brianjk66/Controls-Research-Project/Ordered Parts/Bill of Materials.xlsx

Part | Quantity | Manufacturer | Manufacturer's Part # | Vendor | Vendor's Part # | Unit Price | Total Price | Description | Link
Ball Bearings | 2 | BC Precision | 50BC608ZZ | Amazon | 692128467461 | $0.38 | $0.76 | 608ZZ 8x22x7 Shielded Greased Miniature Ball Bearings | https://www.amazon.com/8x22x7-Shielded-Greased-Miniature-Bearings/dp/B00NX3F6F0
12V Power Supply | 1 | Lighting EVER | 5000028-US | Amazon | B00DKSI0S8 | $9.99 | $9.99 | LE Power Adapter, Transformers, Power Supply For LED Strip, Output 12V DC, 3A Max, 36 Watt Max, UL Listed | https://www.amazon.com/gp/product/B00DKSI0S8/ref=ox_sc_act_title_1?smid=AAF37WJS3P6BT&psc=1
M2 Screws | 2 | uxcell | A15120300UX0205 | Amazon | B01AXUS1MK | $0.07 | $0.14 | M2x14mm Thread Button Head Hex Socket Cap Screw Bolt | https://www.amazon.com/dp/B01AXUS1MK/_encoding=UTF8?coliid=I1D9HRL21A9ZG0&colid=1JXZ7HW0RYXH1&psc=0
M2 Nuts | 2 | uxcell | A16041800UX0465 | Amazon | B01MXF5HPM | $0.04 | $0.09 | M2 x 1.5mm Brass Internal Threaded Hexagon Hex Nuts | https://www.amazon.com/dp/B01MXF5HPM/_encoding=UTF8?coliid=I2JM7CYB0853WF&colid=1JXZ7HW0RYXH1&psc=0
M3 Screws | 4 | StarTech | SCREWM3 | Amazon | B00032Q1J4 | $0.10 | $0.41 | PC Mounting Computer Screws M3x1/4" Long Standoff, 50 Pack | https://www.amazon.com/dp/B00032Q1J4/_encoding=UTF8?coliid=I3N2TUG8GXM37M&colid=1JXZ7HW0RYXH1&psc=1
M3 Standoffs | 4 | uxcell | A12092200UX0087 | Amazon | 31161816 | $0.14 | $0.56 | 50 Pcs M3 Male x M3 Female Hex PCB Standoffs 12mm Length | https://www.amazon.com/uxcell%C2%AE-Female-Standoffs-Spacers-Length/dp/B00AH8DEVW
M3 Nuts | 4 | Amico | A13092700UX0955 | Amazon | 700724341402 | $0.05 | $0.18 | 100Pcs M3 3mm Female Thread Hex Metal Nut Fastener | https://www.amazon.com/100Pcs-Female-Thread-Fastener-Silver/dp/B00GYS1SXU?rps=1
M4 Screws | 1 | Small Parts | FSCM440JISSZ | Amazon | B00F32EDI0 | $0.16 | $0.16 | Steel Machine Screw, Zinc Plated, M4, 40 mm Length | https://www.amazon.com/gp/product/B00F32EDI0/ref=oh_aui_detailpage_o00_s00?ie=UTF8&psc=1
M4 Nuts | 1 | uxcell | A15052500UX0288 | Amazon | B0143GL55A | $0.07 | $0.07 | Metric M4 Hex Nut 304 Stainless Steel Fastener 100pcs | https://www.amazon.com/gp/product/B0143GL55A/ref=oh_aui_detailpage_o00_s00?ie=UTF8&psc=1
Microcontroller | 1 | Elegoo | EL-CB-005 | Amazon | B0713XK923 | $3.95 | $3.95 | Arduino Nano V3.0, Elegoo Nano ATmega328P | https://www.amazon.com/gp/product/B0713XK923/ref=ox_sc_act_title_8?smid=A2WWHQ25ENKVJ1&psc=1
Programming Cable | 1 | AmazonBasics | 3S44_24 | Amazon | B0718XZKWH | $2.00 | $2.00 | USB 2.0 Cable - A-Male to Mini-B, 3 Feet (0.9 Meters) | https://www.amazon.com/gp/product/B0718XZKWH/ref=oh_aui_detailpage_o03_s00?ie=UTF8&psc=1
Bullet Plugs | 3 | Pixnor | B0113N3D42 | Amazon | B0113N3D42 | $0.23 | $0.69 | 2.0mm Gold Plated Male and Female Bullet Banana Connectors | https://www.amazon.com/Pixnor-Plated-Female-Connectors-Battery/dp/B0113N3D42
2.54mm Female Headers | 2 | uxcell | TRTV5112 | Amazon | B00TGOJE1W | $0.12 | $0.23 | 50Pcs Straight Female PCB Header 40 Way 2.54mm Spacing | https://www.amazon.com/gp/product/B00TGOJE1W/ref=ox_sc_act_title_1?smid=A1THAZDOWP300U&psc=1
2:1 Heat Shrink Tubing | 1 | Innhom | HS-532B | Amazon | B075WR9FVL | $0.16 | $0.16 | 532pcs 2:1 Heat Shrink Tubing Insulation Protection Kit | https://www.amazon.com/gp/product/B075WR9FVL/ref=oh_aui_detailpage_o01_s00?ie=UTF8&psc=1
3:1 Heat Shrink Tubing | 1 | Ginsco | A270 | Amazon | 610731355845 | $0.19 | $0.19 | 270Pcs 3:1 Dual Wall Adhesive Lined Heat Shrink Tubing Kit | https://www.amazon.com/gp/product/B073R69KNB/ref=oh_aui_detailpage_o01_s01?ie=UTF8&psc=1
Brushless Motor | 1 | Emax | 045000055-0 | Hobby King | 045000055-0 | $11.66 | $11.66 | Gemfan M1306L 3100kv Brushless Outrunner Motor/Emax RS1306 3300KV Race Spec Motor | https://hobbyking.com/en_us/m1306l-brushless-motor-for-rc-model-aircraft-ccw.html | https://hobbyking.com/en_us/emax-rs1306-racespec-motor-kv3300-cw-shaft-rotation.html?wrh_pdp=3
Electronic Speed Controller (ESC) | 1 | Turnigy | 9351000086-0 | Hobby King | 9351000086-0 | $9.73 | $9.73 | Turnigy MultiStar 20A BLHeli-S Rev16 V3 ESC 2~4S (Opto) | https://hobbyking.com/en_us/blheli-s-20a.html?wrh_pdp=3
Propellors | 1 | Gemfan | 329000341-0 | Hobby King | 329000341-0 | $0.01 | $0.01 | Carbon/Nylon 5030 2-Blade Propeller Black (CW/CCW) (1 Pair) | https://hobbyking.com/en_us/gemfan-propeller-5x3-black-cw-ccw-2pcs-1.html
Black Silicone Wire | 1 | Turnigy | 150000148-0 | Hobby King | 150000148-0 | $0.10 | $0.10 | Turnigy High Quality 20AWG Silicone Wire (Black) | https://hobbyking.com/en_us/turnigy-high-quality-20awg-silicone-wire-15m-black.html?___store=en_us
Red Silicone Wire | 1 | Turnigy | 150000149-0 | Hobby King | 150000149-0 | $0.10 | $0.10 | Turnigy High Quality 20AWG Silicone Wire (Red) | https://hobbyking.com/en_us/turnigy-high-quality-20awg-silicone-wire-15m-red.html?wrh_pdp=3&___store=en_us
Power MOSFET | 1 | Infineon Technologies | IRLB8748PBF | Arrow | IRLB8748PBF | $0.58 | $0.58 | Trans MOSFET N-CH Si 30V 92A 3-Pin(3+Tab) TO-220AB | https://www.arrow.com/en/products/irlb8748pbf/infineon-technologies-ag
Rotary Position Sensor | 1 | Murata Manufacturing | SV03A103AEA01R00 | Arrow | SV03A103AEA01R00 | $0.90 | $0.90 | 10k Rotary Position Sensor SMD T/R | https://www.arrow.com/en/products/sv03a103aea01r00/murata-manufacturing
DC Power Jack | 1 | CUI Inc | PJ-038AH | Arrow | PJ-038AH | $0.53 | $0.53 | Conn DC Power RCP 2 POS Panel Mount 3 Terminal | https://www.arrow.com/en/products/pj-038ah/cui-inc
Rocker Switch | 1 | ZF Electronics | SRB22A2DBBNN | Arrow | SRB22A2DBBNN | $0.63 | $0.63 | Switch Rocker ON OFF SPST 10A 250VAC 100,000 Cycles | https://www.arrow.com/en/products/srb22a2dbbnn/zf-electronics
Crimp Contacts | 10 | TE Connectivity | 1375819-1 | Arrow | 1375819-1 | $0.03 | $0.30 | Contact SKT Crimp ST Cable Mount 22-26AWG Reel Automotive | https://www.arrow.com/en/products/1375819-1/te-connectivity
2 Pin Header | 2 | TE Connectivity | 640455-2 | Arrow | 640455-2 | $0.04 | $0.08 | Conn Wire to Board HDR 2 POS 2.54mm Solder RA Thru-Hole | https://www.arrow.com/en/products/640455-2/te-connectivity
4 Pin Header | 1 | TE Connectivity | 640455-4 | Arrow | 640455-4 | $0.08 | $0.08 | Conn Wire to Board HDR 4 POS 2.54mm Solder RA Thru-Hole | https://www.arrow.com/en/products/640455-4/te-connectivity
2 Pin Receptacle | 2 | TE Connectivity | 1375820-2 | Arrow | 1375820-2 | $0.06 | $0.13 | Conn Housing RCP 2 POS 2.54mm Crimp ST Cable Mount | https://www.arrow.com/en/products/1375820-2/te-connectivity
PCB Fabrication | 1 | JLCPCB | N/A | JLCPCB | N/A | $0.39 | $0.39 | 40mm x 40mm Printed Circuit Board | https://jlcpcb.com/quote
 |  |  |  |  |  | Total | $44.81
Other Costs
PLA
