brianjk66/Controls-Research-Project/Ordered Parts/Expense Report.xlsx

Description | Date of Purchase | Purchaser | Receipt | Cost | Items
Amazon Order 1 | 2017-10-24 | Brian | Amazon Order 1.pdf | $35.65 | MPU-9250 Sensor, MPU-6050 Sensor, Jumper Wires, 3pc Arduino Nanos
Hobby King Order 1 | 2017-10-25 | Brian | Hobby King Order 1.pdf | $48.12 | Propellers, Battery Pack, Charger, ESCs
Amazon Order 2 | 2017-10-25 | Brian | Amazon Order 2.pdf | $7.90 | 608ZZ Bearings (8 pcs)
Amazon Order 3 | 2017-11-02 | Morgan | Amazon Order 3.pdf | $6.99 | 2mm Male & Female Bullet Plugs (20 pcs)
Amazon Order 4 | 2017-11-02 | Morgan | Amazon Order 4.pdf | $13.99 | 30W AC/DC Power Adapter
Hobby King Order 2 | 2017-11-06 | Brian | Hobby King Order 2.pdf | $87.13 | Propellers, Silicone Wire, XT60 Connectors, Motors, ESCs
Amazon Order 5 | 2017-12-15 | Brian | Amazon Order 5.pdf | $149.87 | Soldering Materials, Crimping tool, Silicone Wire, Alligator Clips, Heat Shrink Tubing, Resistors, Capacitors
Digi-Key Order 1 | 2017-12-15 | Brian | Digi-Key Order 1.pdf | $52.58 | Solder Wick, 0.1" Connectors (Male and Female), Crimp Contacts
Arrow Order 1 | 2017-12-15 | Brian | Arrow Order 1.pdf | $45.22 | Slip Rings, Power MOSFETs, Rocker Switches
Amazon Order 6 | 2017-12-15 | Brian | Amazon Order 6.pdf | $147.68 | Soldering Station, Tip Cleaner, Tip Tinner, Extra Iron Tips
Banggood Order 1 | 2017-12-23 | Brian | Banggood Order 1.pdf | $23.08 | 120W AC/DC Power Adapter
Hobby King Order 3 | 2017-12-27 | Brian | Hobby King Order 3.pdf | $74.79 | Higher Voltage, Low KV Motors
Digi-Key Order 2 | 2017-12-28 | Brian | Digi-Key Order 2.pdf | $21.51 | 5.5x2.5mm Barrel Jacks
Arrow Order 2 | 2018-01-17 | Brian | Arrow Order 2.pdf | $24.74 | ATtiny85, Voltage Regulators, Rotary Position Sensors, MOSFETs, SMD Capacitors
Amazon Order 7 | 2018-02-05 | Brian | Amazon Order 7.pdf | $42.37 | M3 screws, M3 standoffs, M3 nuts, M2 screws, M2 nuts, 60W AC/DC Power Adapter
Arrow Order 3 | 2018-02-05 | Brian | Arrow Order 3.pdf | $17.29 | 0.1" PCB headers, receptacles, and crimp contacts
OSH Park | 2018-02-05 | Brian | OSH Park Order.pdf | $19.00 | Teensy 3.2
Arrow Order 4 | 2018-02-19 | Dr. Feron | Arrow Order 4.pdf | $288.71 | PCB connectors, crimp contacts, barrel jacks, rocker switches, and rotary position sensors
Hobby King Order 4 | 2018-02-19 | Dr. Feron | Hobby King Order 4.pdf* | $2115.54 | Brushless Motors and ESCs
Amazon Order 8 | 2018-02-19 | Dr. Feron | Amazon Order 8.pdf | $387.12 | Arduino Nanos
Amazon Order 9 | 2018-02-19 | Dr. Feron | Amazon Order 9.pdf** | $204.40 | Mounting screws, nuts, and standoffs, AC/DC Power Adapter, Programming Cable, and Ball Bearings
Hobby King Order 5 | 2018-02-20 | Brian | Hobby King Order 5.pdf | $35.73 | 20AWG Black and Red Silicone Wire
Amazon Order 10 | 2018-02-22 | Morgan | Amazon Order 10.pdf | $101.29 | Female PCB Headers, 2mm Bullet Plugs, M3 screws
Arrow Order 5 | 2018-02-24 | Morgan | Arrow Order 5.pdf | $58.73 | N-Channel MOSFETs
Amazon Order 11 | 2018-02-24 | Morgan | Amazon Order 11.pdf | $209.04 | Longer Programming Cables
JLCPCB Order | 2018-02-24 | Morgan | JLCPCB Order.pdf | $58.07 | PCB Manufacturing
Amazon Order 12 | 2018-02-27 | Morgan | Amazon Order 12.pdf | $27.97 | 12V Test Power Adapters
Amazon Order 13 | 2018-03-05 | Dr. Feron | Amazon Order 13.pdf | $995.37 | 12V Finalized Power Adapters
Amazon Order 14 | 2018-03-11 | Morgan | Amazon Order 14.pdf | $25.01 | M4 screws & nuts
Amazon Order 15 | 2018-04-01 | Brian | Amazon Order 15.pdf | $16.98 | Heat Shrink Tubing
Home Depot Order | 2018-04-01 | Morgan | Home Depot Order 1.pdf | $30.43 | Wire Strippers
 |  |  | Total Expenses | $5372.30
 |  |  | *Refunded $23.58 after 2 motors were out of stock
 |  |  | **Refunded $8.18 for an incorrect shipment, an additional $326.00 for returned USB cables, and another $999.00 for returned power adapters
