brianjk66/Controls-Research-Project/Voltage Divider.xlsx

Top (Input) Voltage: | 8.4 | Volts
Total Resistance: | 495 | Ohms
R1/R2: | 0.68
R1 Value | 200.3571429 | Ohms
R2 Value | 294.6428571 | Ohms
Total Current Draw | 0.01696969697 | Amps
R1 Power Dissipation | 0.0576969697 | Watts
R2 Power Dissipation | 0.08484848485 | Watts
Total Power Dissipation | 0.1425454545 | Watts
