brianjk66/Controls-Research-Project/0.1 inch header order.xlsx

 |  | Mouser |  | Digikey
Plating | Reel? | 50ct | 100ct | 50ct | 100ct
Tin | Yes | N/A | N/A | $2.64 (https://www.digikey.com/product-detail/en/harwin-inc/M20-1160046/952-3097-1-ND/5995214) | $5.10 (https://www.digikey.com/product-detail/en/harwin-inc/M20-1160046/952-3097-1-ND/5995214)
Tin | No | N/A | $6.95 (https://www.mouser.com/ProductDetail/Harwin/M20-1180046/?qs=pYcASEcTDE4tjBjrymC1ng%3D%3D) | $4.35 (https://www.digikey.com/product-detail/en/harwin-inc/M20-1180046/952-2159-ND/3728125) | $8.41 (https://www.digikey.com/product-detail/en/harwin-inc/M20-1180046/952-2159-ND/3728125)
Gold | Yes | $3.00 (https://www.mouser.com/ProductDetail/Harwin/M20-1160042/?qs=pYcASEcTDE5O1Aia4WrhLw%3D%3D) | $4.80 (https://www.mouser.com/ProductDetail/Harwin/M20-1160042/?qs=pYcASEcTDE5O1Aia4WrhLw%3D%3D) | $2.97 (https://www.digikey.com/product-detail/en/harwin-inc/M20-1160042/952-2157-1-ND/3728122) | $5.74 (https://www.digikey.com/product-detail/en/harwin-inc/M20-1160042/952-2157-1-ND/3728122)
Gold | No | $4.35 (https://www.mouser.com/ProductDetail/Harwin/M20-1180042/?qs=pYcASEcTDE4r0B52MhViPw%3D%3D) | $7.00 (https://www.mouser.com/ProductDetail/Harwin/M20-1180042/?qs=pYcASEcTDE4r0B52MhViPw%3D%3D) | $4.35 (https://www.digikey.com/product-detail/en/harwin-inc/M20-1180042/952-2158-ND/3728124) | $8.41 (https://www.digikey.com/product-detail/en/harwin-inc/M20-1180042/952-2158-ND/3728124)
 |  | 5ct | 10ct | 5ct | 10ct
8-Pin Housing | N/A | $1.75 (https://www.mouser.com/ProductDetail/Harwin/M20-1060800/) | $2.45 (https://www.mouser.com/ProductDetail/Harwin/M20-1060800/) | $1.80 (https://www.digikey.com/product-detail/en/harwin-inc/M20-1060800/952-2234-ND/3728198) | $3.36 (https://www.digikey.com/product-detail/en/harwin-inc/M20-1060800/952-2234-ND/3728198)
