brianjk66/Controls-Research-Project/CAD Files/3D Print Files/Final Parts for Students/Tower.STL

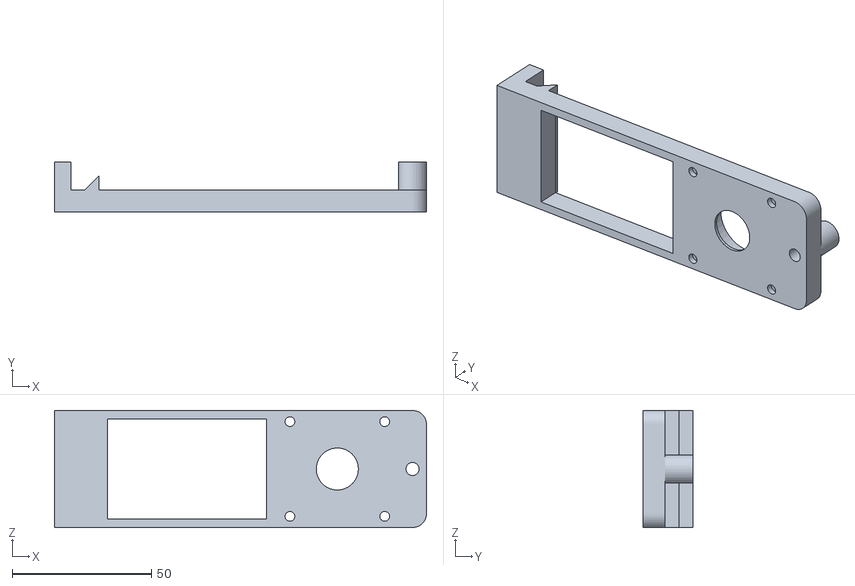
[picture p1: CAD file, 2018-03-12]
CAD Files/3D Print Files/Final Parts for Students/Tower.STL
133.5 x 18.0 x 42.0
