brianjk66/Controls-Research-Project/CAD Files/3D Print Files/Teensy Configuration/FinalBase9.0.STL

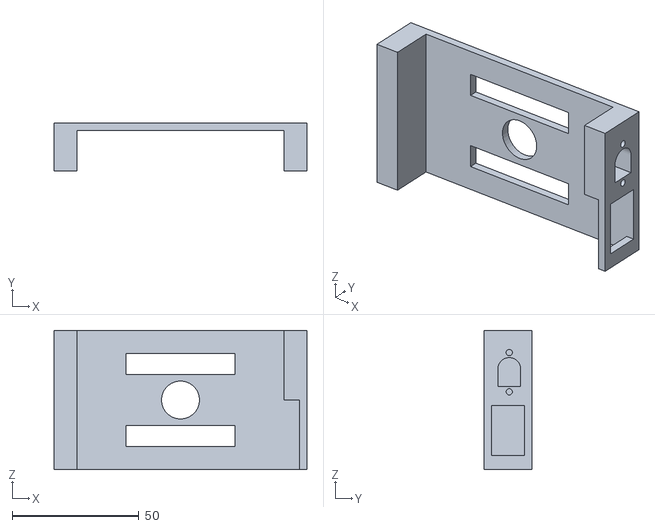
[picture p2: CAD file, 2018-02-16]
CAD Files/3D Print Files/Teensy Configuration/FinalBase9.0.STL
100.0 x 19.0 x 55.0
