brianjk66/Controls-Research-Project/CAD Files/SolidWorks Parts/Dual Motor/Arm.SLDPRT

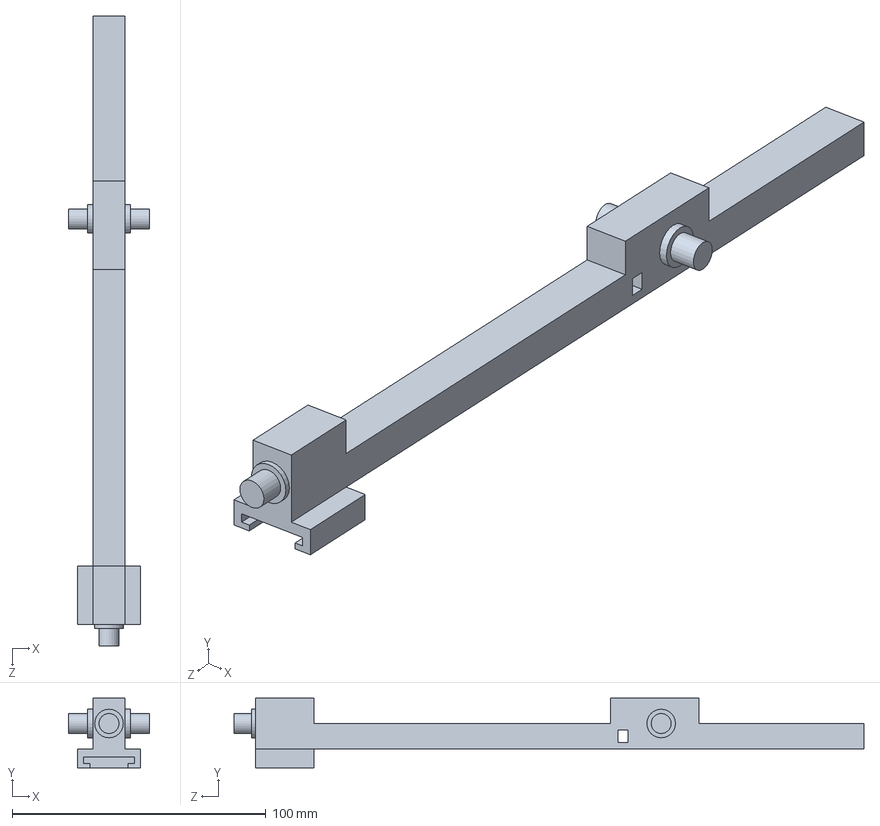
[picture p3: CAD file, 2018-02-05]
CAD Files/SolidWorks Parts/Dual Motor/Arm.SLDPRT
32.0 x 27.5 x 248.5 mm
