brianjk66/Controls-Research-Project/CAD Files/SolidWorks Parts/Misc/Single Motor Mount.SLDPRT

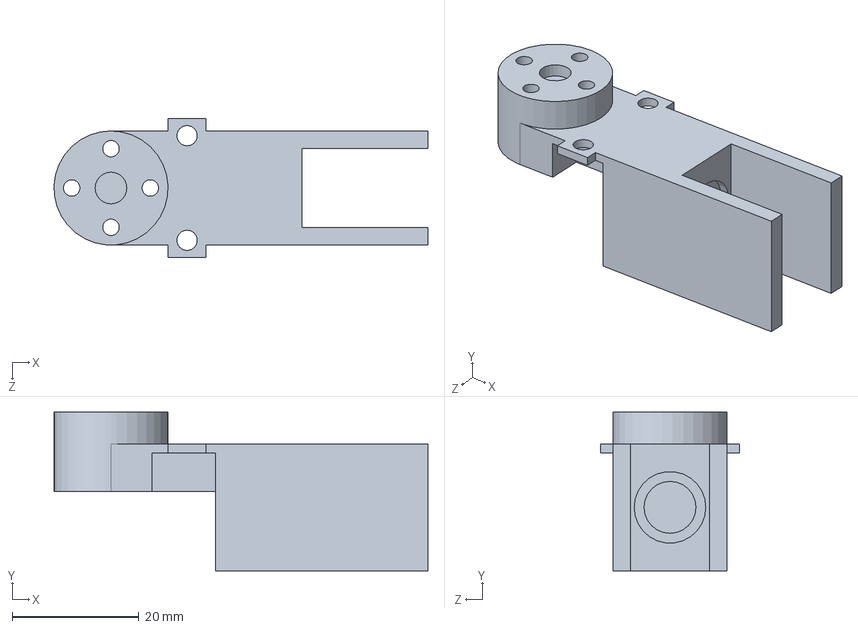
[picture p4: CAD file, 2018-02-04]
CAD Files/SolidWorks Parts/Misc/Single Motor Mount.SLDPRT
59.0 x 25.0 x 22.0 mm
