brianjk66/Controls-Research-Project/CAD Files/SolidWorks Parts/Dual Motor/Rotating Base (Modified).SLDPRT

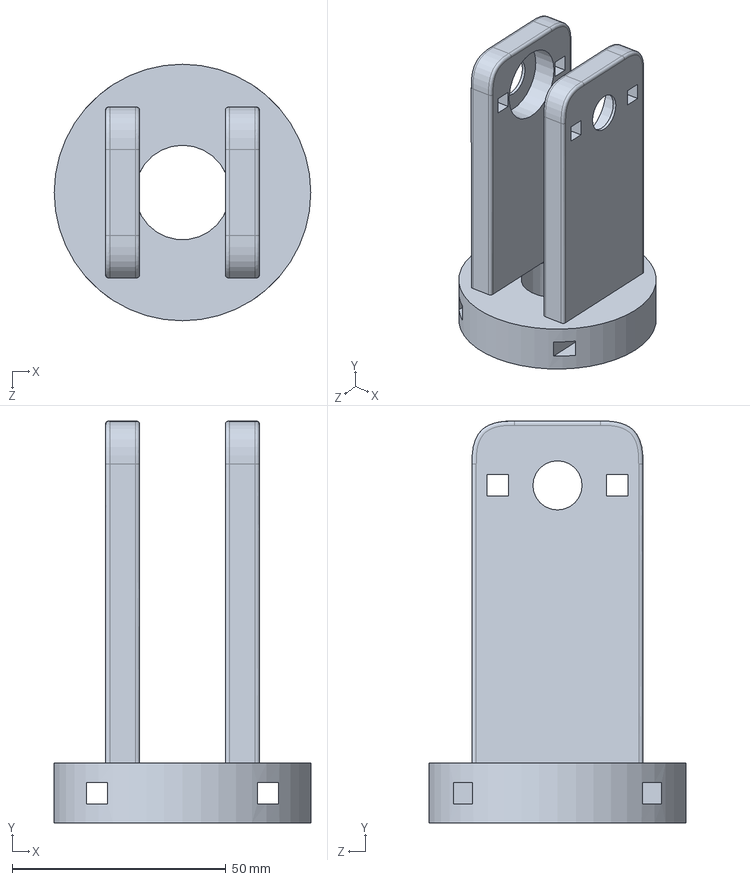
[picture p5: CAD file, 2018-01-18]
CAD Files/SolidWorks Parts/Dual Motor/Rotating Base (Modified).SLDPRT
60.0 x 94.0 x 60.0 mm
