brianjk66/Controls-Research-Project/CAD Files/SolidWorks Parts/Misc/Fixed Base V2.SLDPRT

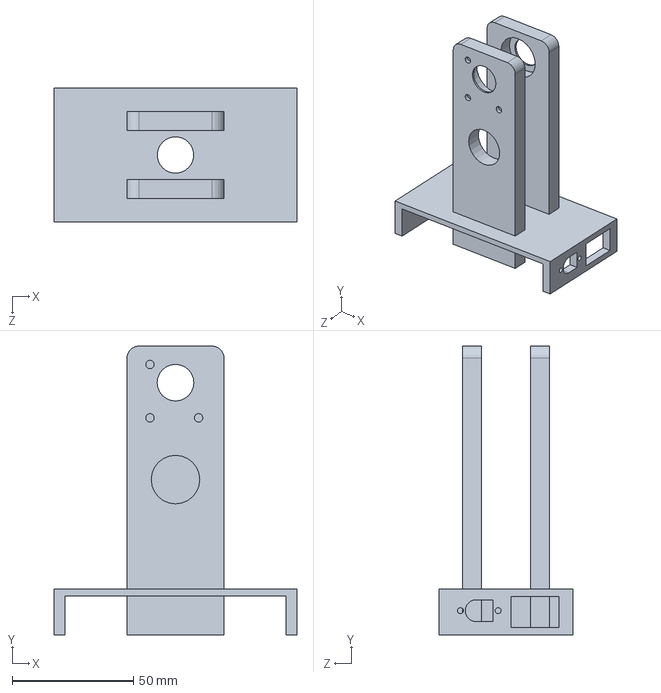
[picture p6: CAD file, 2018-02-04]
CAD Files/SolidWorks Parts/Misc/Fixed Base V2.SLDPRT
100.0 x 119.0 x 55.0 mm
