brianjk66/Controls-Research-Project/CAD Files/3D Print Files/Final Parts for Students/Shaft.STL

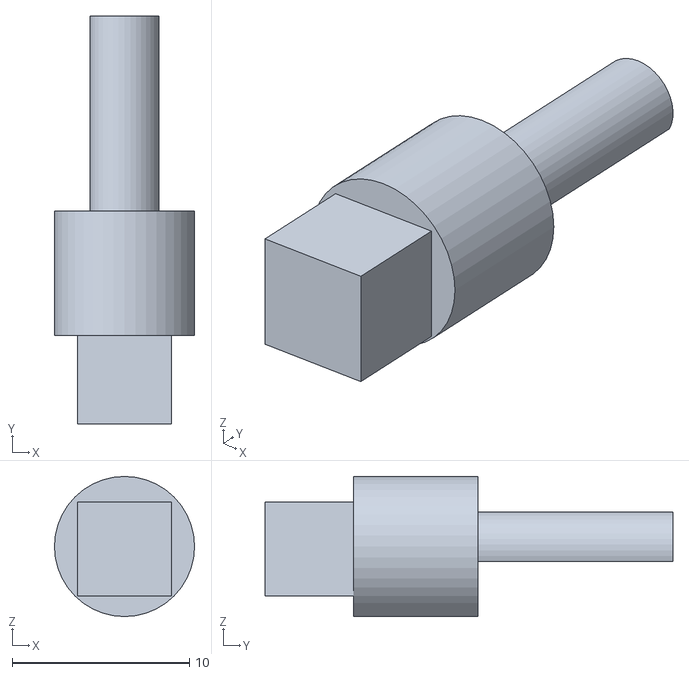
[picture p7: CAD file, 2018-02-28]
CAD Files/3D Print Files/Final Parts for Students/Shaft.STL
7.90 x 23.0 x 7.90
