brianjk66/Controls-Research-Project/CAD Files/SolidWorks Parts/Dual Motor/Dual Motor Mount.SLDPRT

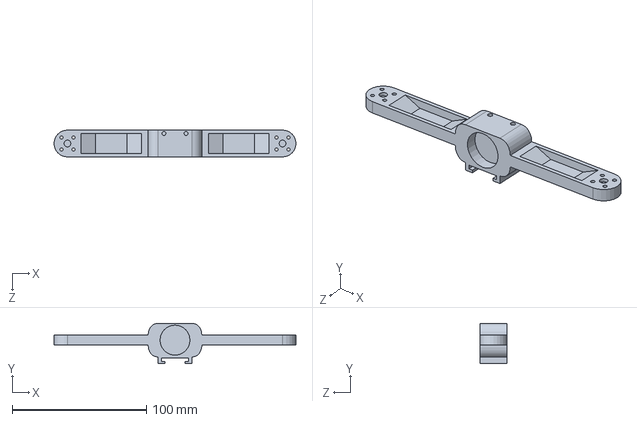
[picture p8: CAD file, 2017-11-22]
CAD Files/SolidWorks Parts/Dual Motor/Dual Motor Mount.SLDPRT
180.0 x 30.0 x 20.0 mm
