brianjk66/Controls-Research-Project/CAD Files/3D Print Files/Final Parts for Students/Arm.STL

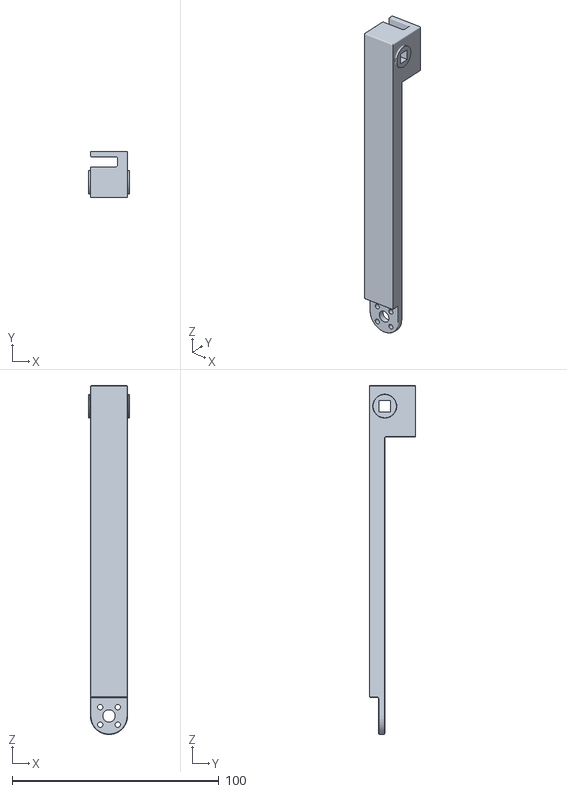
[picture p9: CAD file, 2018-02-28]
CAD Files/3D Print Files/Final Parts for Students/Arm.STL
20.0 x 22.5 x 169.0
