brianjk66/Controls-Research-Project/CAD Files/3D Print Files/Teensy Configuration/FinalTower.STL

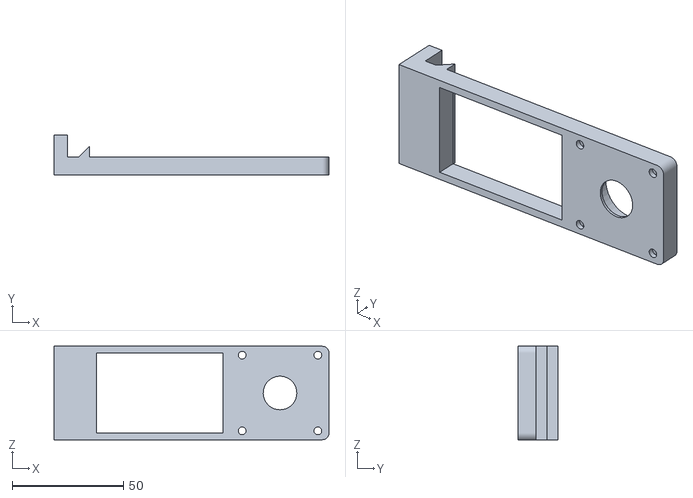
[picture p10: CAD file, 2018-02-16]
CAD Files/3D Print Files/Teensy Configuration/FinalTower.STL
123.5 x 18.0 x 42.0
