brianjk66/Controls-Research-Project/CAD Files/SolidWorks Parts/Dual Motor/Base.SLDPRT

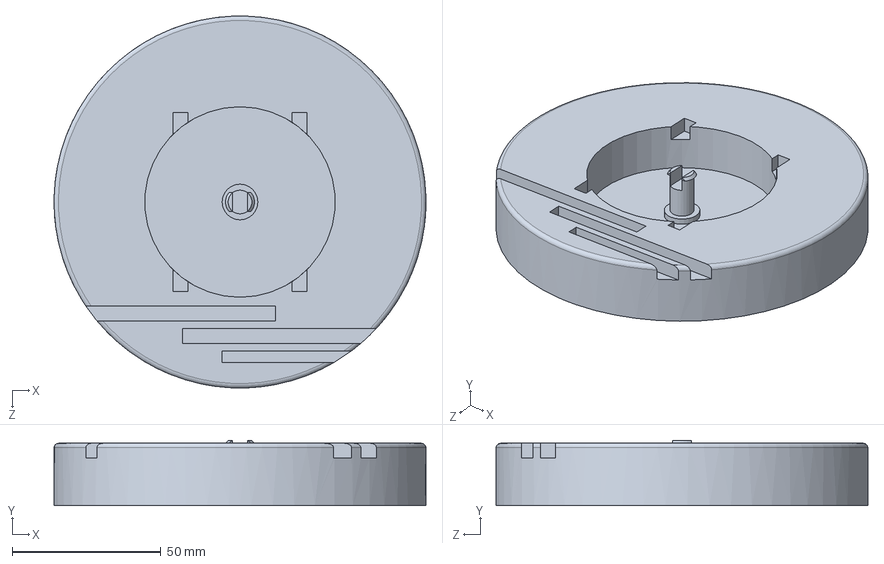
[picture p11: CAD file, 2017-11-22]
CAD Files/SolidWorks Parts/Dual Motor/Base.SLDPRT
124.9 x 22.0 x 125.0 mm
