brianjk66/Controls-Research-Project/CAD Files/3D Print Files/Teensy Configuration/Shaft 5.5.STL

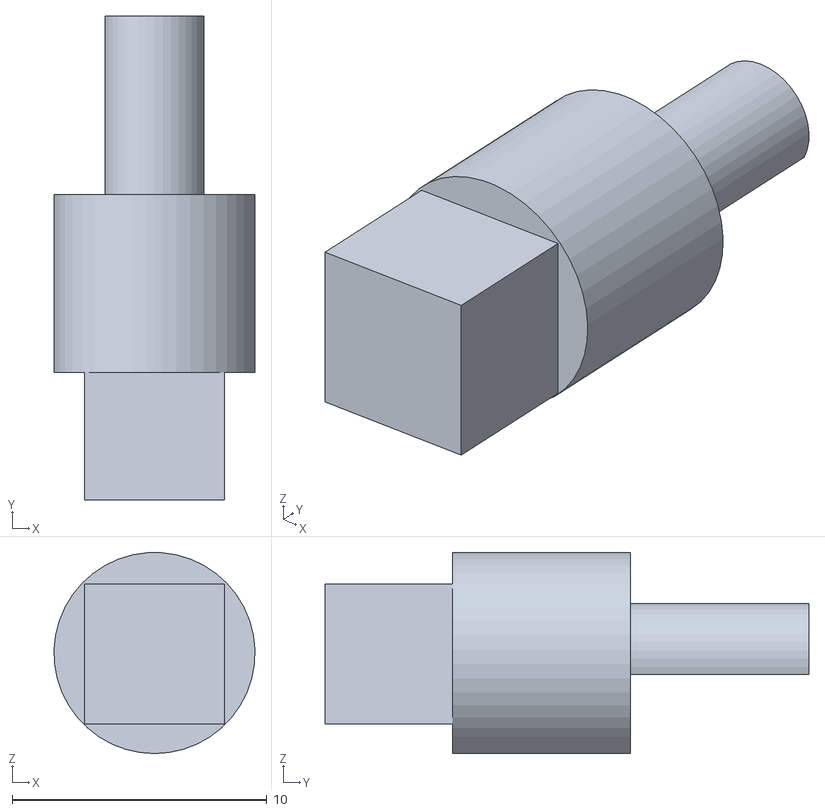
[picture p12: CAD file, 2018-02-12]
CAD Files/3D Print Files/Teensy Configuration/Shaft 5.5.STL
7.89 x 19.0 x 7.90
