brianjk66/Controls-Research-Project/CAD Files/SolidWorks Parts/Dual Motor/Rotating Base.SLDPRT

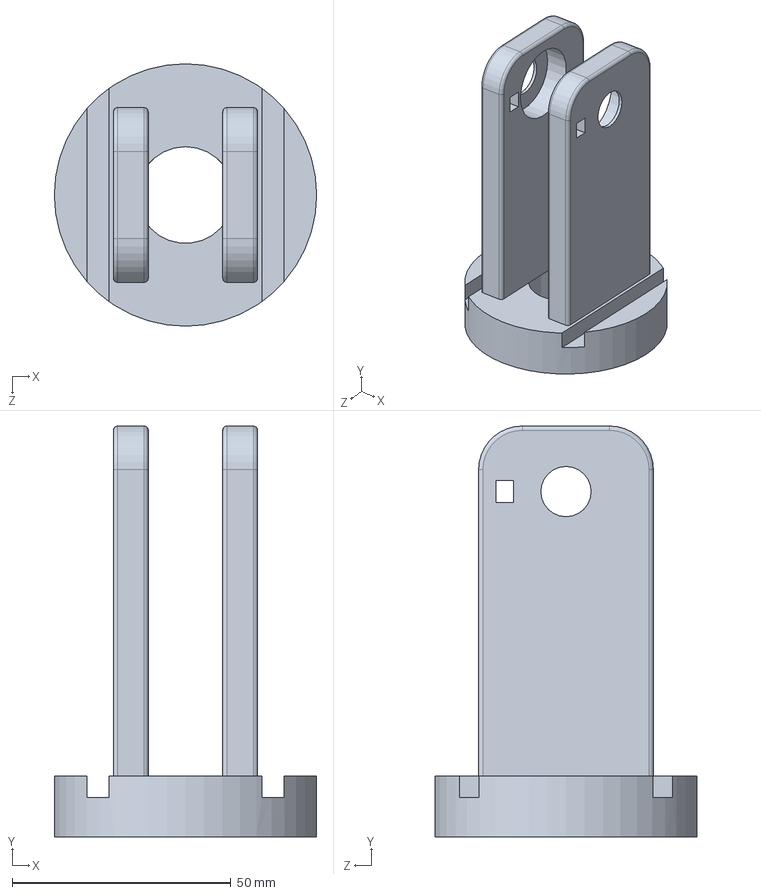
[picture p13: CAD file, 2017-11-21]
CAD Files/SolidWorks Parts/Dual Motor/Rotating Base.SLDPRT
60.0 x 94.0 x 60.0 mm
