brianjk66/Controls-Research-Project/CAD Files/3D Print Files/Teensy Configuration/Shaft 5.2.STL

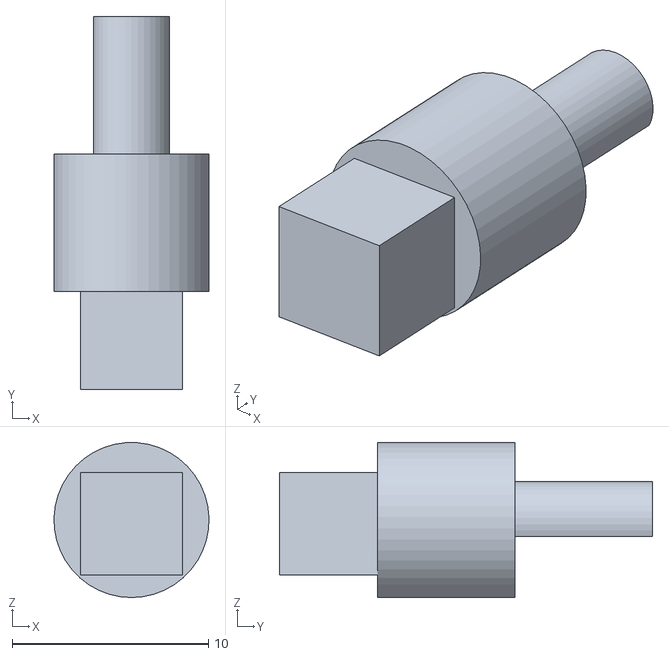
[picture p14: CAD file, 2018-02-12]
CAD Files/3D Print Files/Teensy Configuration/Shaft 5.2.STL
7.89 x 19.0 x 7.90
