brianjk66/Controls-Research-Project/CAD Files/SolidWorks Parts/Dual Motor/Roll Lock.SLDPRT

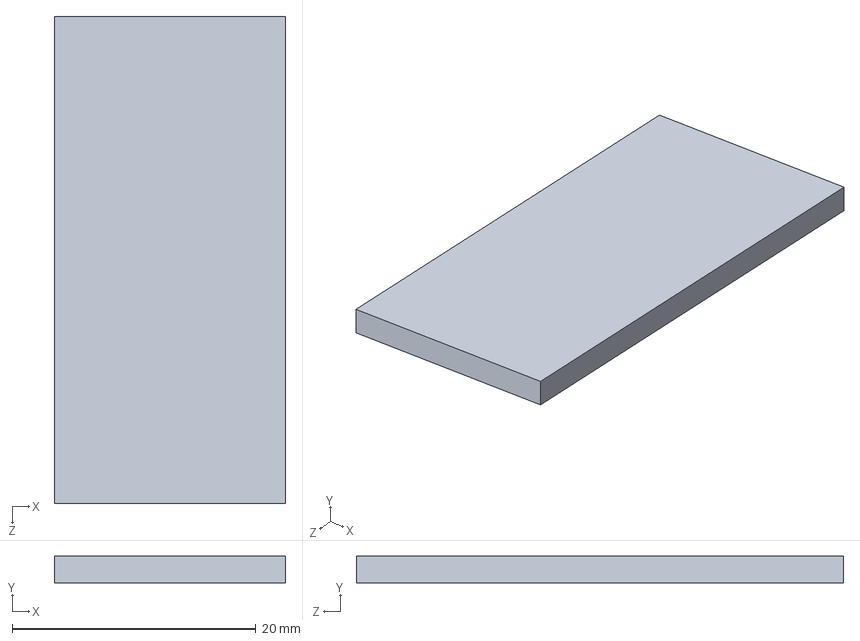
[picture p15: CAD file, 2017-11-17]
CAD Files/SolidWorks Parts/Dual Motor/Roll Lock.SLDPRT
19.0 x 2.20 x 40.0 mm
