brianjk66/Controls-Research-Project/CAD Files/3D Print Files/Teensy Configuration/Shaft 5.3 8.0.STL

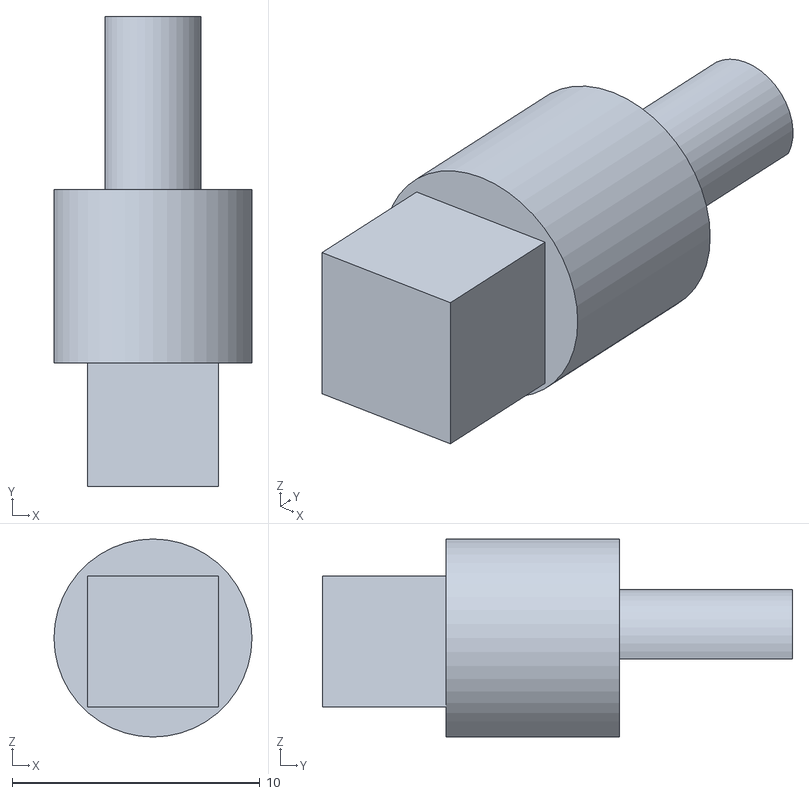
[picture p16: CAD file, 2018-02-12]
CAD Files/3D Print Files/Teensy Configuration/Shaft 5.3 8.0.STL
8.00 x 19.0 x 8.00
