brianjk66/Controls-Research-Project/CAD Files/3D Print Files/Teensy Configuration/Base Without Towers 9.0 Barrel Test.STL

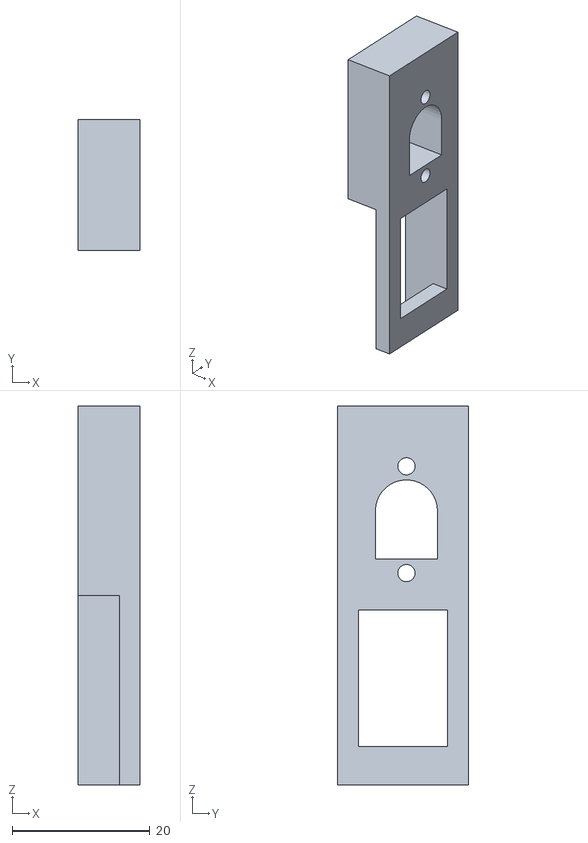
[picture p17: CAD file, 2018-02-12]
CAD Files/3D Print Files/Teensy Configuration/Base Without Towers 9.0 Barrel Test.STL
9.00 x 19.0 x 55.0
