brianjk66/Controls-Research-Project/CAD Files/3D Print Files/Teensy Configuration/Shaft 5.5 8.0.STL

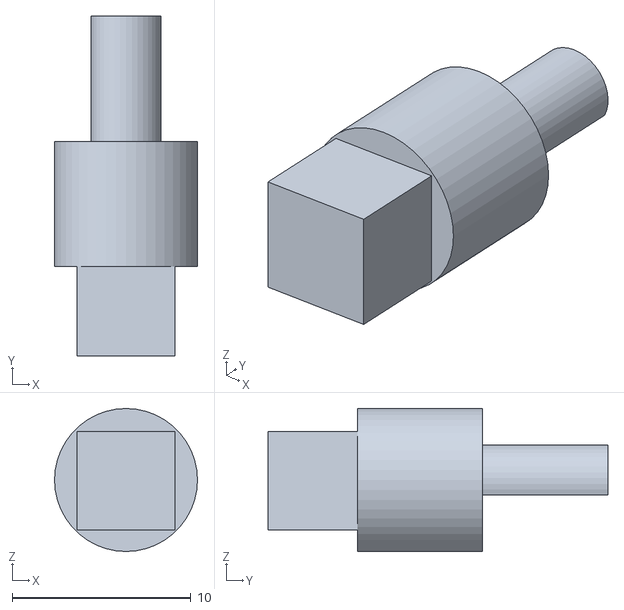
[picture p18: CAD file, 2018-02-12]
CAD Files/3D Print Files/Teensy Configuration/Shaft 5.5 8.0.STL
8.00 x 19.0 x 8.00
