brianjk66/Controls-Research-Project/CAD Files/3D Print Files/Teensy Configuration/Tower.STL

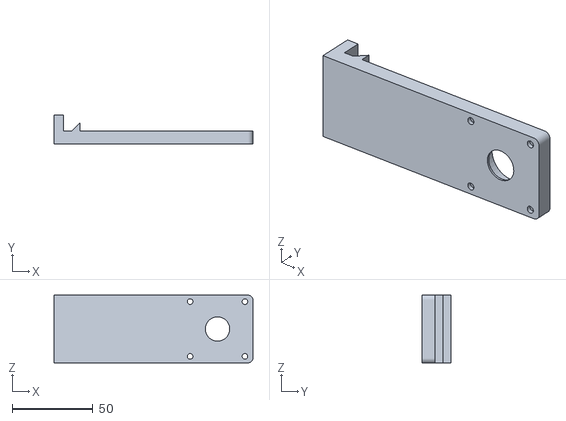
[picture p19: CAD file, 2018-02-05]
CAD Files/3D Print Files/Teensy Configuration/Tower.STL
123.5 x 18.0 x 42.0
