brianjk66/Controls-Research-Project/CAD Files/3D Print Files/Teensy Configuration/Single Motor Arm No Shaft.STL

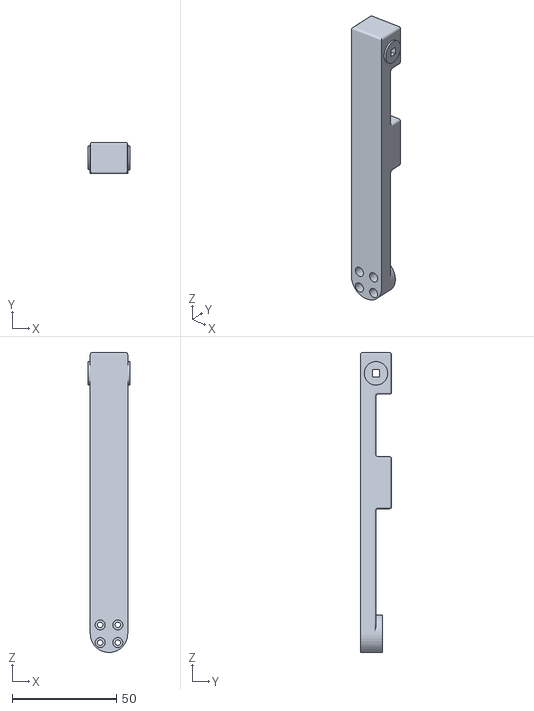
[picture p20: CAD file, 2018-02-04]
CAD Files/3D Print Files/Teensy Configuration/Single Motor Arm No Shaft.STL
20.0 x 15.0 x 144.0
