brianjk66/Controls-Research-Project/(list of files, cad)

Other CAD files:
CAD Files/SolidWorks Parts/Final Configuration/Tower.SLDPRT
CAD Files/3D Print Files/Final Parts for Students/Base.STL
CAD Files/3D Print Files/Teensy Configuration/FinalBase8.9.STL
CAD Files/SolidWorks Parts/Final Configuration/Base Without Towers.SLDPRT
CAD Files/3D Print Files/Teensy Configuration/FinalShaft5.3_7.9_11.STL
CAD Files/SolidWorks Parts/Final Configuration/Shaft.SLDPRT
CAD Files/SolidWorks Parts/Final Configuration/Single Motor Arm No Shaft.SLDPRT
CAD Files/3D Print Files/Teensy Configuration/Shaft 5.4 8.0.STL
CAD Files/3D Print Files/Teensy Configuration/Shaft 5.4.STL
CAD Files/3D Print Files/Teensy Configuration/Base Without Towers 8.9 Barrel Test.STL
CAD Files/3D Print Files/Teensy Configuration/Shaft 5.0.STL
CAD Files/3D Print Files/Teensy Configuration/Base Without Towers Towers 8.8 Barrel Test.STL
CAD Files/3D Print Files/Teensy Configuration/Shaft 5.3.STL
CAD Files/3D Print Files/Teensy Configuration/Shaft 5.1.STL
CAD Files/3D Print Files/Teensy Configuration/Base Without Towers.STL
CAD Files/3D Print Files/Teensy Configuration/Shaft.STL
CAD Files/3D Print Files/Teensy Configuration/Single Motor Arm No Shaft 150mm Center ESC.STL
CAD Files/3D Print Files/Dual Motor/Arm.STL
CAD Files/3D Print Files/Dual Motor/Base.STL
CAD Files/3D Print Files/Dual Motor/Dual Motor Mount.STL
CAD Files/3D Print Files/Dual Motor/Roll Lock.STL
CAD Files/3D Print Files/Dual Motor/Rotating Base.STL
CAD Files/3D Print Files/Misc/Fixed Base V2.STL
CAD Files/3D Print Files/Misc/Single Motor Mount.STL
