brianjk66/Controls-Research-Project/EAGLE Files/Arduino Board rev2/Arduino Board rev2.brd

## EAGLE design EAGLE Files/Arduino Board rev2/Arduino Board rev2.brd (2018-02-21, an earlier design)


Parts:
ESC: M04; 1X04
MOSFET: SI2312; SOT-23
POWER_IN: M02; 1X02
POWER_OUT: M02; 1X02
SENSOR: 10k; SV03A
U$1: ARDUINO_NANO

Connections:
5V: SENSOR.3 (A), U$1.5V
12V: POWER_IN.1, POWER_OUT.1
DRIVE: MOSFET.1 (G), U$1.D10
ESC: ESC.1, U$1.D6
GND: MOSFET.2 (S), POWER_IN.2, SENSOR.1 (E), U$1.GND1
unnamed: MOSFET.3 (D), POWER_OUT.2
SENSE: SENSOR.2 (S), SENSOR.2.1 (S), U$1.A0

Notes on the sheet:
To Barrel Jack
To ESC

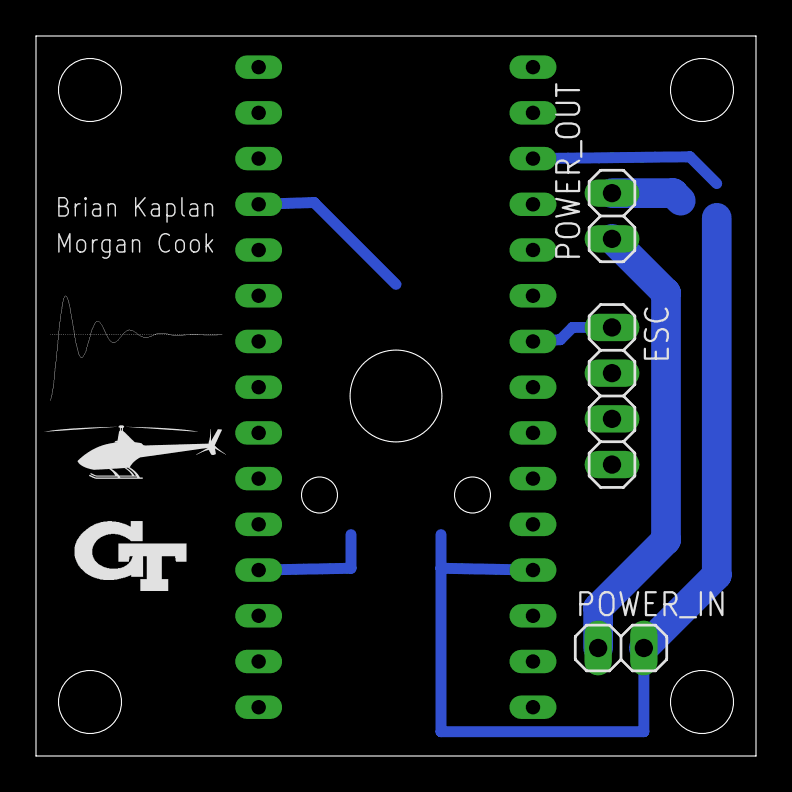
[picture p23: board Arduino Board rev2.brd from above]

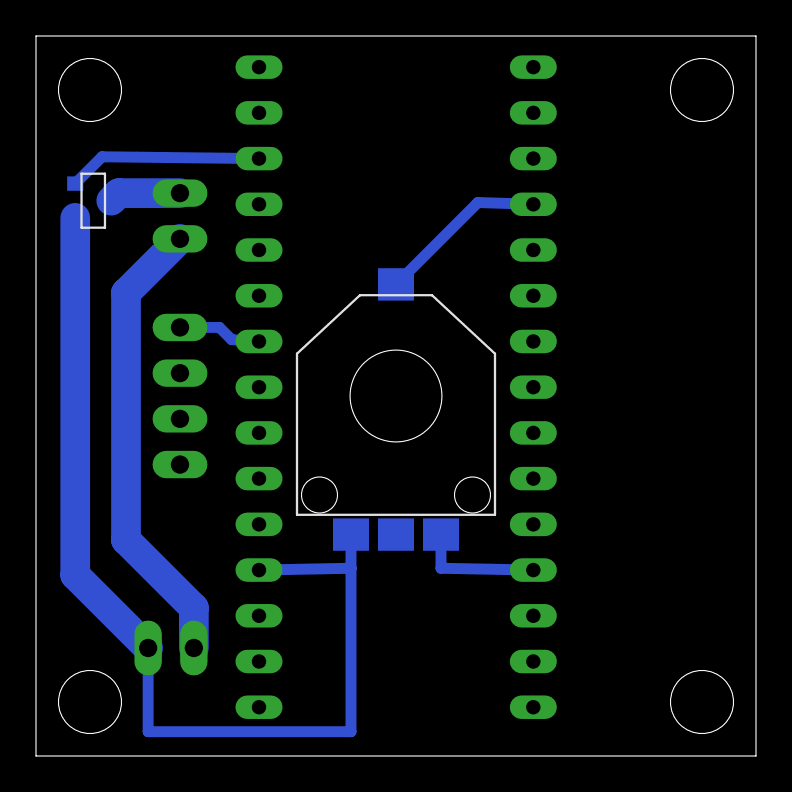
[picture p24: board Arduino Board rev2.brd from below]

Board: 2 copper layers, 40.0 x 40.0 mm, 6 parts (2 on the bottom side), 7 nets.
