brianjk66/Controls-Research-Project/EAGLE Files/Arduino Board rev1/Arduino Board rev1.brd

## EAGLE design EAGLE Files/Arduino Board rev1/Arduino Board rev1.brd (2018-01-18, an earlier design)

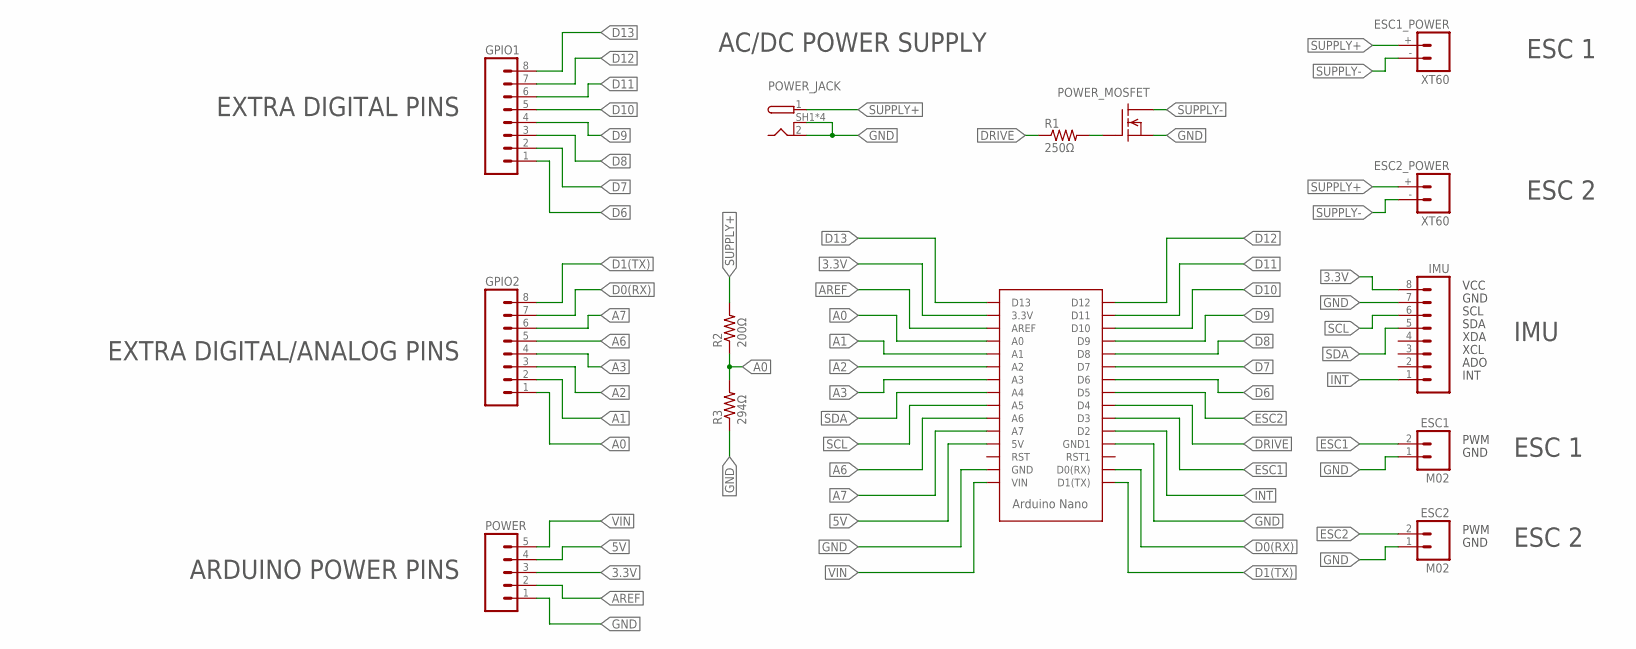
[picture p25: schematic Arduino Board rev1.sch]

Parts:
ESC1, ESC2: M02; 1X02
ESC1_POWER, ESC2_POWER: XT60
GPIO1, GPIO2: M08; 1X08
IMU: M08; 1X08
POWER: M05; 1X05
POWER_JACK: PJ-082BH
POWER_MOSFET: N-CHANNEL_MOSFETGENERIC; TO-220-SINK
R1: 250Ω; AXIAL-0.4
R2: 200Ω; AXIAL-0.4
R3: 294Ω; AXIAL-0.4
U$1: ARDUINO_NANO

Connections:
3.3V: IMU.8, POWER.3, U$1.3.3V
5V: POWER.4, U$1.5V
A0: GPIO2.1, R2.P$1 (1), R3.P$2 (2), U$1.A0
A1: GPIO2.2, U$1.A1
A2: GPIO2.3, U$1.A2
A3: GPIO2.4, U$1.A3
A6: GPIO2.5, U$1.A6
A7: GPIO2.6, U$1.A7
AREF: POWER.2, U$1.AREF
D0(RX): GPIO2.7, U$1.D0(RX)
D1(TX): GPIO2.8, U$1.D1(TX)
D6: GPIO1.1, U$1.D6
D7: GPIO1.2, U$1.D7
D8: GPIO1.3, U$1.D8
D9: GPIO1.4, U$1.D9
D10: GPIO1.5, U$1.D10
D11: GPIO1.6, U$1.D11
D12: GPIO1.7, U$1.D12
D13: GPIO1.8, U$1.D13
DRIVE: R1.P$1 (1), U$1.D4
ESC1: ESC1.2, U$1.D3
ESC2: ESC2.2, U$1.D5
GND: ESC1.1, ESC2.1, IMU.7, POWER.1, POWER_JACK.2 (GND), POWER_JACK.SH1 (SHIELD), POWER_JACK.SH2 (SHIELD), POWER_JACK.SH3 (SHIELD), POWER_JACK.SH4 (SHIELD), POWER_MOSFET.3 (S), R3.P$1 (1), U$1.GND, U$1.GND1
INT: IMU.1, U$1.D2
unnamed: POWER_MOSFET.1 (G), R1.P$2 (2)
SCL: IMU.6, U$1.A5
SDA: IMU.5, U$1.A4
SUPPLY+: ESC1_POWER.+ (2), ESC2_POWER.+ (2), POWER_JACK.1 (PWR), R2.P$2 (2)
SUPPLY-: ESC1_POWER.- (1), ESC2_POWER.- (1), POWER_MOSFET.2 (D)
VIN: POWER.5, U$1.VIN

Notes on the sheet:
VCC
GND
SCL
SDA
XDA
XCL
ADO
INT
PWM
ESC 1
ESC 2
IMU
AC/DC POWER SUPPLY
EXTRA DIGITAL PINS
EXTRA DIGITAL/ANALOG PINS
ARDUINO POWER PINS

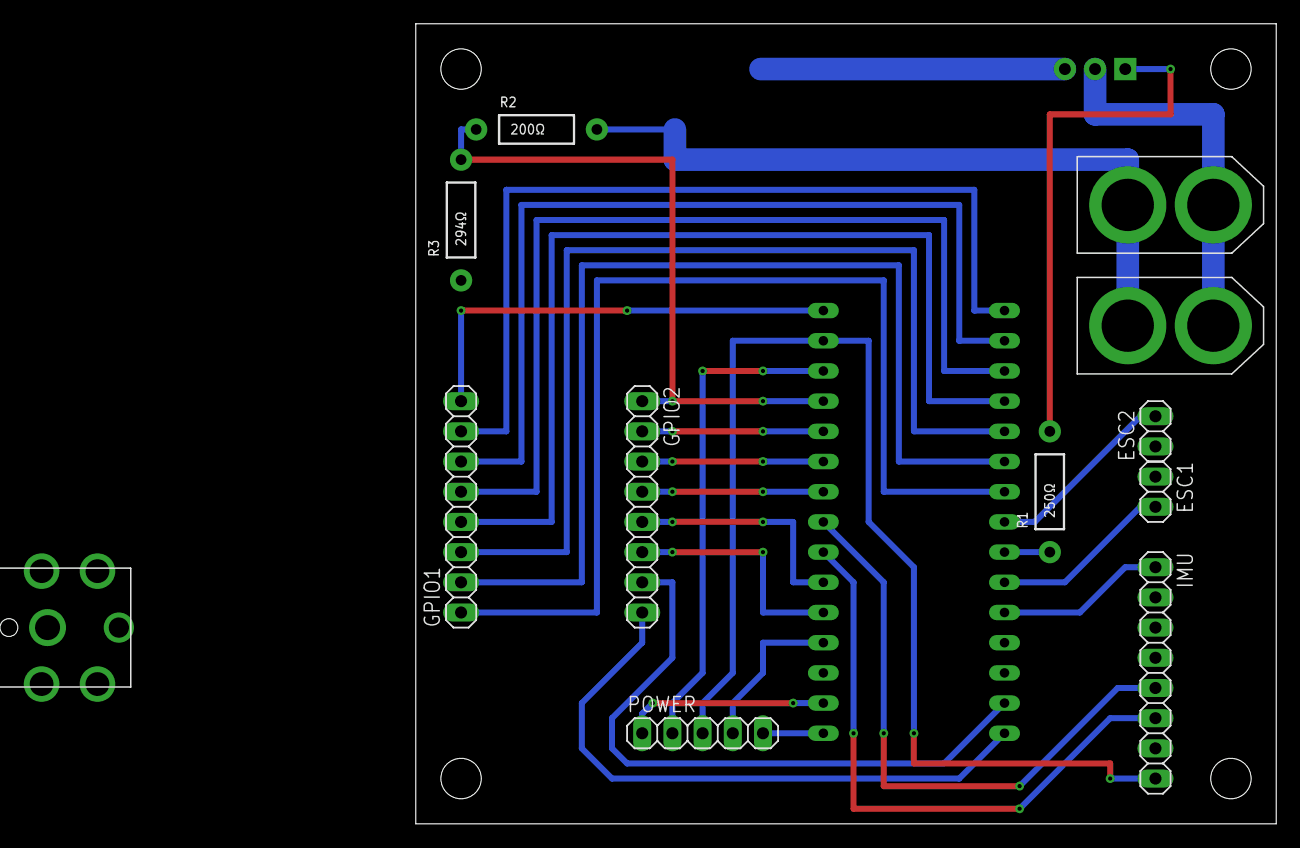
[picture p26: board Arduino Board rev1.brd from above]

Board: 2 copper layers, 72.4 x 67.3 mm, 14 parts (1 on the bottom side), 30 nets.
