brianjk66/Controls-Research-Project/EAGLE Files/Teensy Board/Teensy Board.brd

## EAGLE design EAGLE Files/Teensy Board/Teensy Board.brd (2018-02-05)

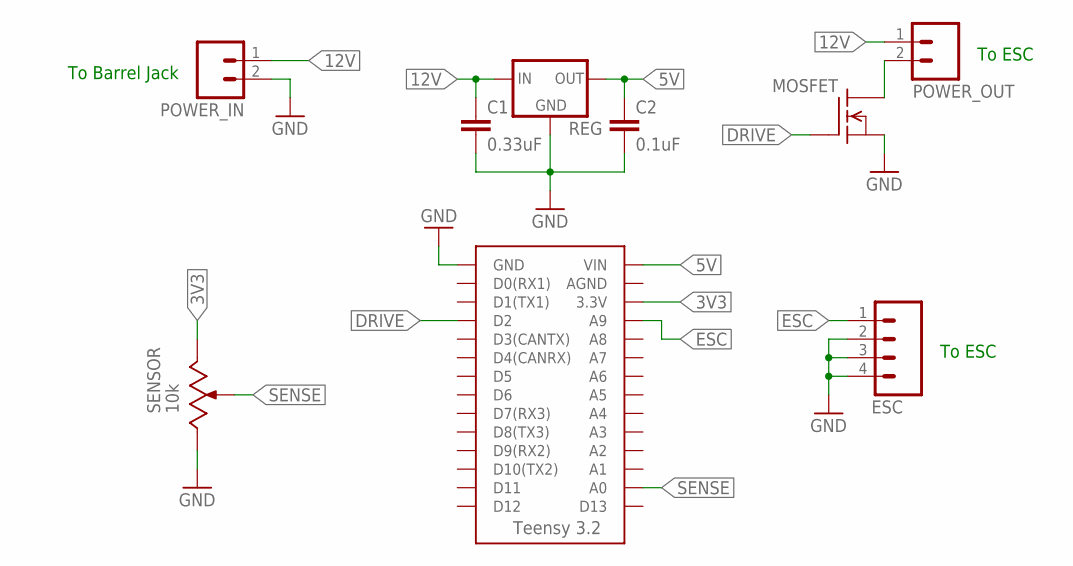
[picture p27: schematic Teensy Board.sch]

Parts:
C1: 0.33uF; 0805
C2: 0.1uF; 0805
ESC: M04; 1X04
MOSFET: SI2312; SOT-23
POWER_IN: M02; 1X02
POWER_OUT: M02; 1X02
REG: L78L; SOT-89
SENSOR: 10k; SV03A
U$2: TEENSY_3.2_SIMPLE

Connections:
3V3: SENSOR.1 (E), U$2.3.3V
5V: C2.1, REG.1 (OUT), U$2.VIN
12V: C1.1, POWER_IN.1, POWER_OUT.1, REG.3 (IN)
DRIVE: MOSFET.1 (G), U$2.D2
ESC: ESC.1, U$2.A9
GND: C1.2, C2.2, ESC.2, ESC.3, ESC.4, MOSFET.2 (S), POWER_IN.2, REG.2 (GND), REG.2.1 (GND), REG.2.2 (GND), SENSOR.3 (A), U$2.GND
unnamed: MOSFET.3 (D), POWER_OUT.2
SENSE: SENSOR.2 (S), SENSOR.2.1 (S), U$2.A0

Notes on the sheet:
To Barrel Jack
To ESC

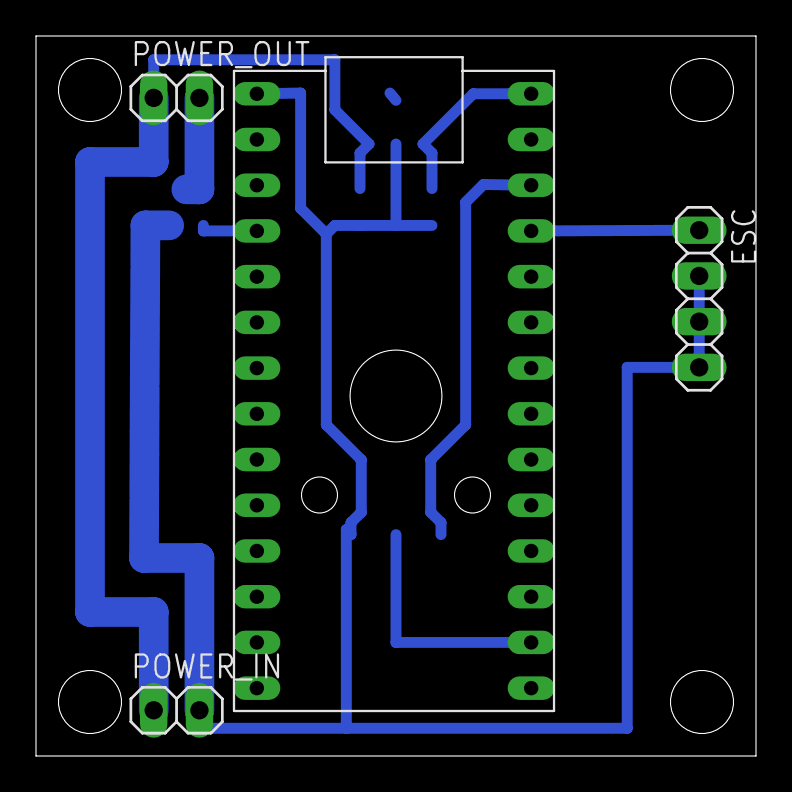
[picture p28: board Teensy Board.brd from above]

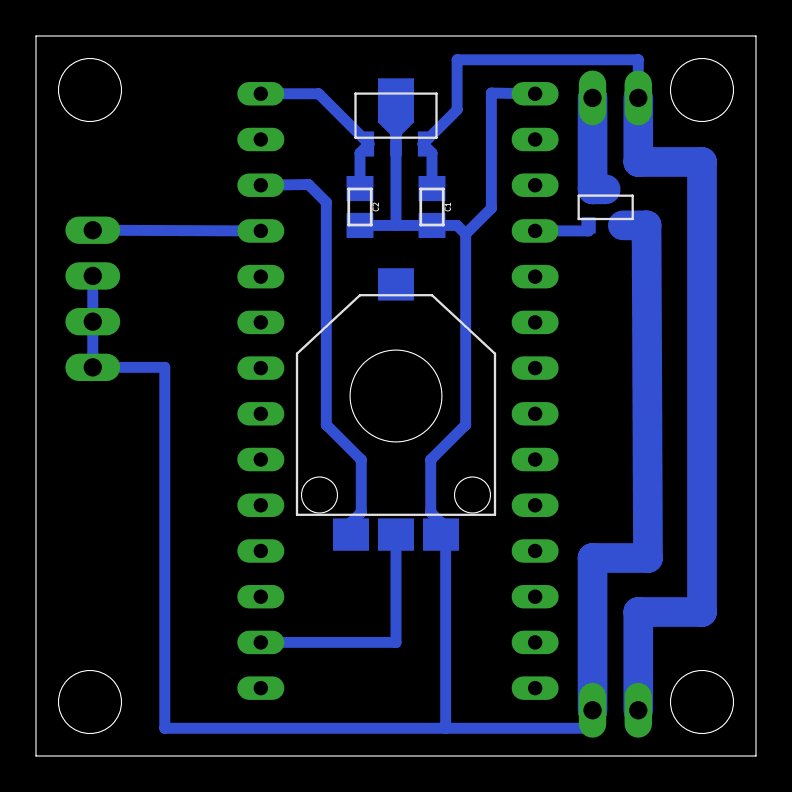
[picture p29: board Teensy Board.brd from below]

Board: 2 copper layers, 40.0 x 40.0 mm, 9 parts (5 on the bottom side), 8 nets.
