brianjk66/Controls-Research-Project/EAGLE Files/ATtiny85 Board/ATtiny85 Board.brd

## EAGLE design EAGLE Files/ATtiny85 Board/ATtiny85 Board.brd (2018-01-25)

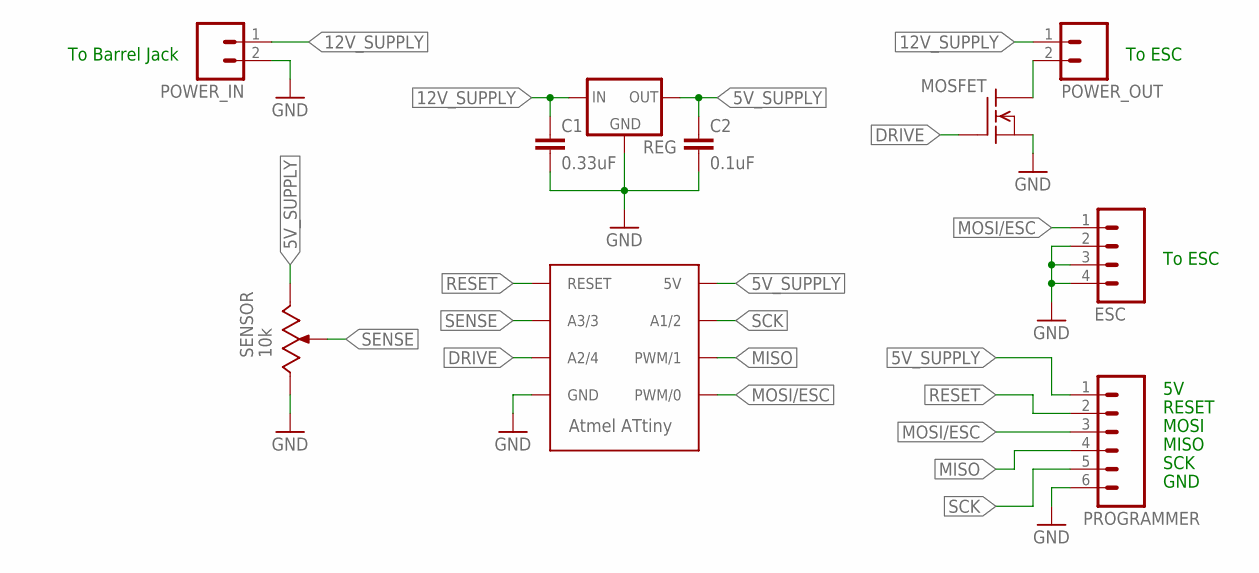
[picture p30: schematic ATtiny85 Board.sch]

Parts:
C1: 0.33uF; 0805
C2: 0.1uF; 0805
ESC: M04; 1X04
MOSFET: SI2312; SOT-23
POWER_IN: M02; 1X02
POWER_OUT: M02; 1X02
PROGRAMMER: M06; 1X06
REG: L78L; SOT-89
SENSOR: 10k; SV03A
U$1: ATTINY; 8S2

Connections:
5V_SUPPLY: C2.1, PROGRAMMER.1, REG.1 (OUT), SENSOR.1 (E), U$1.8 (5V)
12V_SUPPLY: C1.1, POWER_IN.1, POWER_OUT.1, REG.3 (IN)
DRIVE: MOSFET.1 (G), U$1.3 (A2/4)
GND: C1.2, C2.2, ESC.2, ESC.3, ESC.4, MOSFET.2 (S), POWER_IN.2, PROGRAMMER.6, REG.2 (GND), REG.2.1 (GND), REG.2.2 (GND), SENSOR.3 (A), U$1.4 (GND)
MISO: PROGRAMMER.4, U$1.6 (PWM/1)
MOSI/ESC: ESC.1, PROGRAMMER.3, U$1.5 (PWM/0)
unnamed: MOSFET.3 (D), POWER_OUT.2
RESET: PROGRAMMER.2, U$1.1 (RESET)
SCK: PROGRAMMER.5, U$1.7 (A1/2)
SENSE: SENSOR.2 (S), SENSOR.2.1 (S), U$1.2 (A3/3)

Notes on the sheet:
RESET
MOSI
MISO
SCK
To Barrel Jack
To ESC
GND

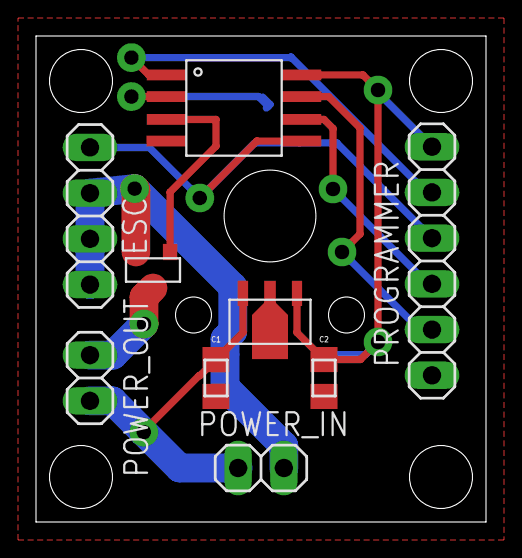
[picture p31: board ATtiny85 Board.brd from above]

Board: 2 copper layers, 25.0 x 27.0 mm, 10 parts (1 on the bottom side), 10 nets.
