brianjk66/Controls-Research-Project/Software/Arduino Code/Dual_ESC_Test/Dual_ESC_Test.ino

// Simple ESC tester program to verify operation
// and operating range of new ESC/Motor pairs

#include <Servo.h> 

Servo ESC1, ESC2;
int speed = 0;

void arm(){
  setSpeed(0); //Sets speed variable
  delay(1000);
}

void setSpeed(int input_speed){
  int us = map(input_speed, 0, 1000, 1000, 2000); //Sets servo positions to different speed
  ESC1.writeMicroseconds(us);
  ESC2.writeMicroseconds(us);
}

void setup() {
  Serial.begin(9600);
  ESC1.attach(3); //Adds ESC to certain pin.
  ESC2.attach(5); //Adds ESC to certain pin.
  arm();
}

void loop() {
  if (Serial.available()) {
    speed = Serial.parseInt();
    Serial.println(speed);
    setSpeed(speed);
  }
}
