brianjk66/Controls-Research-Project/(commit log)

2017-11-17 Initial Commit of Current Project
    Arduino files, ordered parts, and other project files
    [BOM.xlsx, Itemized Receipts.xlsx]
2017-11-17 Test Commit
    [Motor Mount (One motor FIXED).STL]
2017-11-17 CAD files initial upload
    [Arm.SLDPRT, Arm.STL, Motor Mount (One motor FIXED).SLDPRT, Motor Mount (One motor FIXED).STL, Motor Mount 2 Rotors.SLDPRT, Motor Mount 2 Rotors.STL, Roll Lock.SLDPRT, Roll Lock.STL]
2017-11-17 Removed git commit test file
    [Motor Mount (One motor FIXED).STL]
2017-11-17 Renamed CAD files
    [Dual Motor Mount.SLDPRT, Dual Motor Mount.STL, Single Motor Mount.SLDPRT, Single Motor Mount.STL]
2017-11-17 Enlarged center hole for both MMs
    [Dual Motor Mount.SLDPRT, Dual Motor Mount.STL, Single Motor Mount.SLDPRT, Single Motor Mount.STL]
2017-11-18 Reorganized CAD files
    [Arm.SLDPRT, Arm.STL, Dual Motor Mount.SLDPRT, Dual Motor Mount.STL, Roll Lock.SLDPRT, Roll Lock.STL, Single Motor Mount.SLDPRT, Single Motor Mount.STL]
2017-11-18 Added 2MM gcode, .2mm layer thickness
2017-11-18 Fixed mounting hole problem
    [Dual Motor Mount.SLDPRT, Dual Motor Mount.STL]
2017-11-19 Added gcodes for 3D printing the arm and roll lock
2017-11-19 Added preliminary code for dual motor configuration
2017-11-19 Added dual motor pitch controller (gains are NOT tuned)
2017-11-21 Added rotating base 3D files
    [Rotating Base.SLDPRT, Rotating Base.STL]
2017-11-21 Ok REALLY adding in the rotating base this time. Sorry.
    [Rotating Base.SLDPRT, Rotating Base.STL]
2017-11-22 Added base to our files
    [Arm.STL, Base.SLDPRT, Base.STL, Dual Motor Mount.SLDPRT]
2017-12-01 Created prelimiary PCB design to house project's microcontroller and electrical components
    [Arduino Board.brd, Arduino Board.sch]
2017-12-01 Small modification to PID function to constrain value of iState more easily
2017-12-10 Tweaked gains, added constrain() function to PID integrator, and added cosine to thrust drive signal
2017-12-10 Corrected schematic error where MOSFET was wired incorrectly in circuit
    [Arduino Board.brd, Arduino Board.sch]
2017-12-10 Added Arduino sketch for testing control of power MOSFET
2017-12-10 Fixed untracked files
    [0.1 inch header order.xlsx]
2017-12-11 Updated default PID gains to more stable values
2017-12-11 Added voltage divider for simple battery monitoring
    [Arduino Board.brd, Arduino Board.sch]
2017-12-16 Updated itemized receipts spreadsheet and added new order invoices
    [Itemized Receipts.xlsx]
2017-12-18 Updated part orders spreadsheet and invoices
    [Itemized Receipts.xlsx]
2017-12-29 Added new Hobby King and Banggood Orders to itemized receipts sheet
    [Itemized Receipts.xlsx]
2018-01-07 Added barrel jack order from Digi-Key to itemized receipts spreadsheet
    [Itemized Receipts.xlsx]
2018-01-18 Added new Arrow order to itemized receipts spreadsheet
    [Itemized Receipts.xlsx]
2018-01-18 Small changes to PCB design files from EAGLE software update
    [Arduino Board.brd, Arduino Board.sch]
2018-01-18 Added new EAGLE design files for ATtiny85-based PCB
    [ATtiny85 Board.brd, ATtiny85 Board.sch]
2018-01-18 Added new components to library for ATtiny85 PCB design
2018-01-18 Modified Rotating Base part to have fully parametrized dimensions and features
    [Rotating Base (Modified).SLDPRT]
2018-01-21 Added new Arduino code for testing ESC control with the ATtiny85
2018-01-21 Updated BOM with headers and connectors
    [BOM.xlsx]
2018-01-25 Added several new sketches for testing the ATtiny85 with PWM, Serial, PID control, etc.
2018-01-25 Enlarged and repositioned vias for easier milling and soldering
    [ATtiny85 Board.brd, ATtiny85 Board.sch]
2018-01-25 Added standoffs to BOM and quotes from PCB fabrication and assembly plants
    [BOM.xlsx]
2018-01-25 New Base
    [Fixed Base V2.SLDPRT, Fixed Base V2.STL]
2018-02-04 Modified base with towers, made base with open slots for towers, made towers.
    [Base Without Towers.SLDPRT, Base Without Towers.STL, Fixed Base V2.SLDPRT, Tower.SLDPRT, Tower.STL]
2018-02-04 Moved the Tower.stl file back to the 3D print files folder from SolidWorks Parts
    [Tower.STL]
2018-02-04 Fixed dimensions for printing on base and towers
    [Base Without Towers.SLDPRT, Base Without Towers.STL, Tower.SLDPRT, Tower.STL]
2018-02-04 Reorganized .stl and .SLDPRT files into old Dual Motor, Misc (single motor included), and Teensy Configuration.
    [Arm.SLDPRT, Arm.STL, Base Without Towers.SLDPRT, Base Without Towers.STL, Base.SLDPRT, Base.STL, Dual Motor Mount.SLDPRT, Dual Motor Mount.STL]
2018-02-04 Added single motor arm without a shaft. Potentially accidentally modified Arm.SLDPRT in Dual Motor and Single Motor Mount.SLDPRT in Misc.
    [Arm.SLDPRT, Single Motor Arm No Shaft.SLDPRT, Single Motor Arm No Shaft.STL, Single Motor Mount.SLDPRT]
2018-02-05 Actually added shaft.
    [Arm.SLDPRT, Shaft.SLDPRT, Shaft.STL, Single Motor Arm No Shaft.SLDPRT]
2018-02-05 Made shaft size bigger, added a configuration for the arm file for 150mm with a centered ESC sheath, created a separate .STL file for it.
    [Shaft.SLDPRT, Shaft.STL, Single Motor Arm No Shaft 150mm Center ESC.STL, Single Motor Arm No Shaft.SLDPRT]
2018-02-05 Resized the square on shaft from 5.3mm to 4.9mm.
    [Shaft.SLDPRT, Shaft.STL]
2018-02-05 Restructured software directory to distinguish between software for different microcontrollers (Arduino, ATtiny, and Teensy)
2018-02-05 Updated library to include the Teensy 3.2
2018-02-05 Created new PCB design for Teensy configuration
    [Teensy Board.brd, Teensy Board.sch]
2018-02-05 Modified base and towers to accomodate new PCB design and better fit barrel jack and rocker switch
    [Base Without Towers.SLDPRT, Base Without Towers.STL, Tower.SLDPRT, Tower.STL]
2018-02-07 Added a ton of .STL files for print testing in the studio, added new configurations to the base for testing.
    [Base Without Towers 8.9 Barrel Test.STL, Base Without Towers 9.0 Barrel Test.STL, Base Without Towers Towers 8.8 Barrel Test.STL, Base Without Towers.SLDPRT, Shaft 5.0.STL, Shaft 5.1.STL, Shaft 5.2.STL, Shaft 5.3 8.0.STL]
2018-02-12 Updated itemized receipts spreadsheet with latest orders
    [Itemized Receipts.xlsx]
2018-02-14 Hopefully saved the final design of towers, and 2 potential final bases.
    [Base Without Towers.SLDPRT, FinalBase8.9.STL, FinalBase9.0.STL, FinalTower.STL, Tower.SLDPRT]
2018-02-16 Added a longer dowel to the shaft, saved it under final shaft with square side length, bearing diameter, and dowel length in the .stl
    [FinalShaft5.3_7.9_11.STL, Shaft.SLDPRT]
2018-02-16 Added software for testing sensors and ESCs with Teensy 3.2
2018-02-16 Redid the equation to map sensor reading to angle. R^2 value is .99916 git status
2018-02-17 Added PID controller software for Teensy 3.2 with revised controller code
2018-02-17 Added verified default gains, changed macro from PERIOD to FREQUENCY, converted filter from 10 to 100 point averager, and added rounding for measurement precision
2018-02-18 Increased ESC Test code baud rate to 115200 for faster response time
2018-02-21 Reorganized EAGLE design files and added second revision Arduino board design
    [Arduino Board rev1.brd, Arduino Board rev1.sch, Arduino Board rev2.brd, Arduino Board rev2.sch]
2018-02-21 Renamed 'Itemized Receipts.xlsx' to 'Expense Report.xlsx' and added latest purchases to the spreadsheet
    [Arduino Board.brd, Arduino Board.sch, Expense Report.xlsx, Itemized Receipts.xlsx]
2018-02-22 Updated expense report with latest Amazon order and revised HobbyKing order with refunded motors
    [Expense Report.xlsx]
2018-02-22 Created third revision of Arduino board design to feature a through-hole MOSFET, also made some small changes to EAGLE library
    [Arduino Board rev3.brd, Arduino Board rev3.sch]
2018-02-22 Updated bill of materials to reflect latest part selections and orders
    [Teensy Build BOM.xlsx]
2018-02-22 Removed old/outdated bill of materials from earlier build
    [BOM.xlsx]
2018-02-22 Renamed 'Teensy Build BOM.xlsx' to 'Bill of Material.xlsx'
    [Bill of Materials.xlsx]
2018-02-22 Moved all old Arduino code from older builds into an archive folder
2018-02-22 Added new Arduino software files for testing and running the latest build
2018-02-23 Changed Arduino code to reflect new PCB (revision 3) configuration
2018-02-24 Added improved filtering to analog readings, converted from doubles to floats for improved computation time, and changed starting sequence to arm ESC by default
2018-02-25 Added latest orders and invoices to Bill of Materials and Expense Report
    [Bill of Materials.xlsx, Expense Report.xlsx]
2018-02-25 Finalized PCB designs and generated Gerber files for manufacturing
    [Arduino Board rev3.brd, Arduino Board rev3.sch]
2018-02-27 Added invoice from latest Arrow order to expense report
    [Expense Report.xlsx]
2018-02-27 Increased baud rate and added arming by default to ESC testing code
2018-02-28 Added dowel to tower, made tentative final STL files folder.
    [Arm.STL, Base Without Towers.SLDPRT, Base.STL, Shaft.SLDPRT, Shaft.STL, Single Motor Arm No Shaft.SLDPRT, Tower.SLDPRT, Tower.STL]
2018-03-01 Changed base to accomodate the dowels.
    [Base Without Towers.SLDPRT, Base.STL]
2018-03-02 Added most recent Amazon order invoice to expense report
    [Expense Report.xlsx]
2018-03-02 Added macro for sensor pin number
2018-03-02 Changed baud rate back to 115200 for consistency among all Arduino sketches
2018-03-02 Added new power adapter to bill of materials to replace old faulty supply
    [Bill of Materials.xlsx]
2018-03-11 Added proper delays for arming and calibrating plus serial printouts to show user when they complete
2018-03-11 Added resetSystem() function for use during startup, pauses, tuning, etc. to prevent against filter and derivative spiking. Added updatePID flag to limit frequency of serial printouts to once per ref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
    [PID_Controller.ino]
2018-03-12 Extended overshoot dowels to 10mm and added holes through dowels to support M4 bolts for added structural stability
    [Tower.SLDPRT, Tower.STL]
2018-03-12 Added latest orders to Expense Report and updated Bill of Materials with M4 screws and nuts for new Tower modification
    [Bill of Materials.xlsx, Expense Report.xlsx]
2018-04-01 Added most recent Amazon Order for heatshrink tubing to expense report
    [Bill of Materials.xlsx, Expense Report.xlsx]
2018-04-01 Added heat shrink tubing to Bill of Materials
    [Bill of Materials.xlsx]
2018-04-01 Added Home Depot order for wire strippers to expense report
    [Expense Report.xlsx]
2018-04-07 Minor change to sensor test code
2018-04-07 Modified PID controller code to print properly formatted data for serial plotting
2018-04-07 Added new schematic for full eletrical system layout
    [Arduino Board Simplified Schematic.sch]
2018-04-07 Small fix to parentheses in sensor test code
    [Sensor_Test.ino]
2018-04-25 Added test for simultaneously measuring angle and controlling ESC
2018-05-10 Finalized expense report for submission to Georgia Tech
    [Expense Report.xlsx, Finalized Expense Report.xlsx]
